edgecollective/soil-health/arduino/README.md

# dev notes

chirp-feather-m0_encoder_acclimat_voltage_sleep works with the latest chirp stack (and the prior -- so all code is compatible)

the current soil breakout board connects the io pin to pin 12, so that is how the code is set up

chirpstack is admin, admin
[ipaddres]:8080
pi
rakcat999
