edgecollective/soil-health/updates/update_002.md

# Update 2

## Done Previously:

- Remote node connected to acclima, acquiring data
- Gateway posting data to FarmOS
- Gateway posting data to Google Sheets
- Gateway remote login ability at Patrick's (not Dave's)

## Todo:

- Boost radio range
- Assess power consumption on remote node
- Optimize power circuit on remote node (e.g. solar)
- Set gateway up for multiple nodes posting to FarmOS 
- Design remote node that can be mass-produced easily

## Update on todos:
