edgecollective/soil-health/updates/update_003.md

# notes w setup w patrick 03 15 20

## wifi setup

### via file

wpa_supplicant.conf file format if needed, ref: https://www.raspberrypi.org/forums/viewtopic.php?t=203716

### via desktop

## ip endpoint
