edgecollective/soil-health/docs/rak_terminal.png

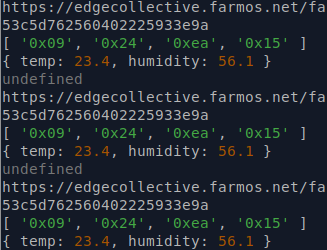
docs/rak_terminal.png
