edgecollective/soil-health/docs/rak_update.png

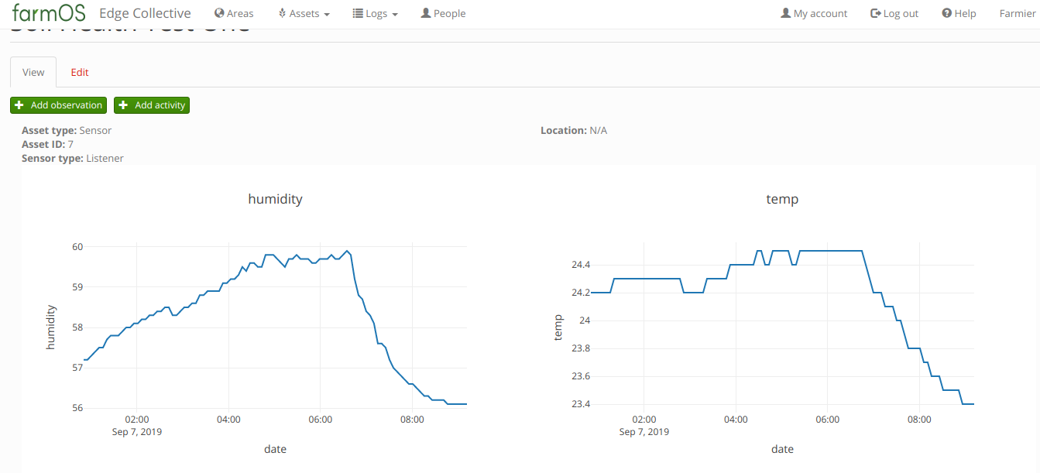
docs/rak_update.png
