edgecollective/soil-health/hardware/remote-v2/sh1/feather_schem.png

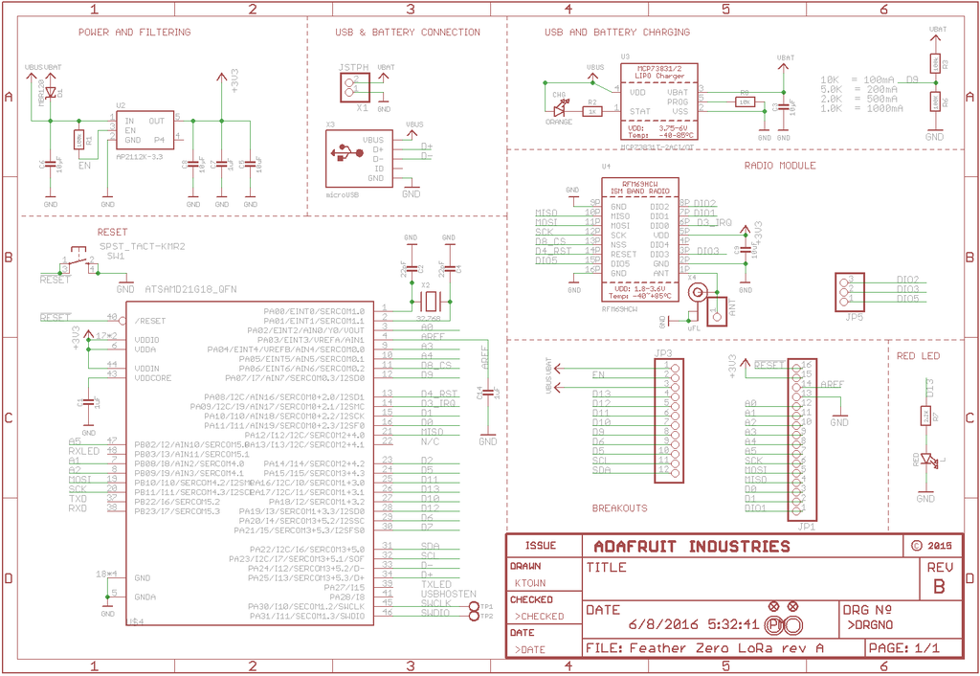
hardware/remote-v2/sh1/feather_schem.png
