edgecollective/soil-health/hardware/remote-v2/sh1/knuth_2.png

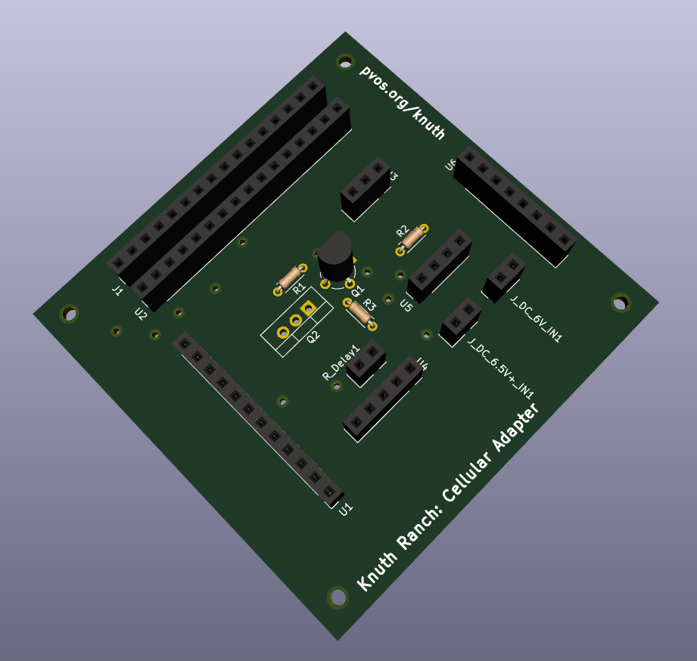
hardware/remote-v2/sh1/knuth_2.png
