edgecollective/soil-health/hardware/remote-v2/sh1/pics/flatcam.png

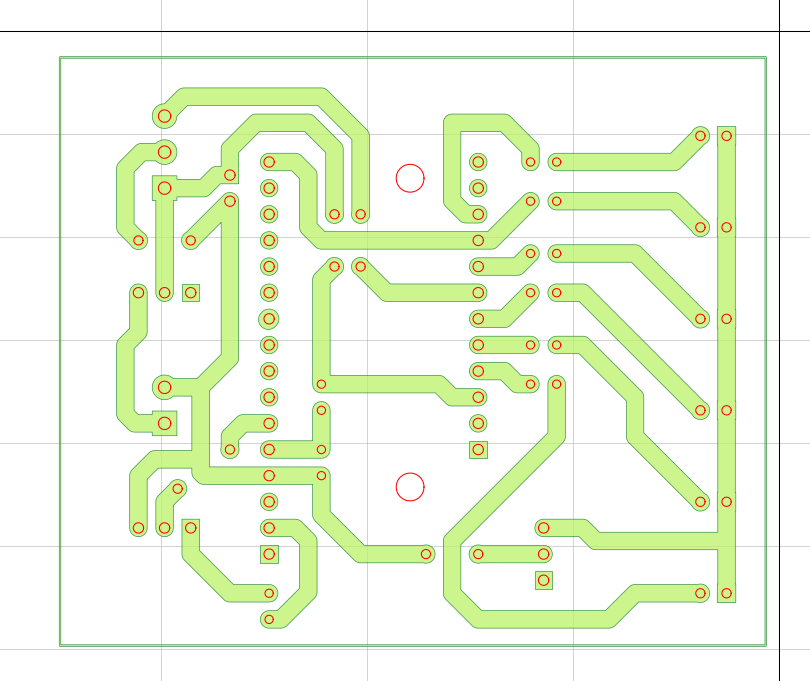
hardware/remote-v2/sh1/pics/flatcam.png
