edgecollective/soil-health/hardware/remote-v2/sh1/pics/layout.png

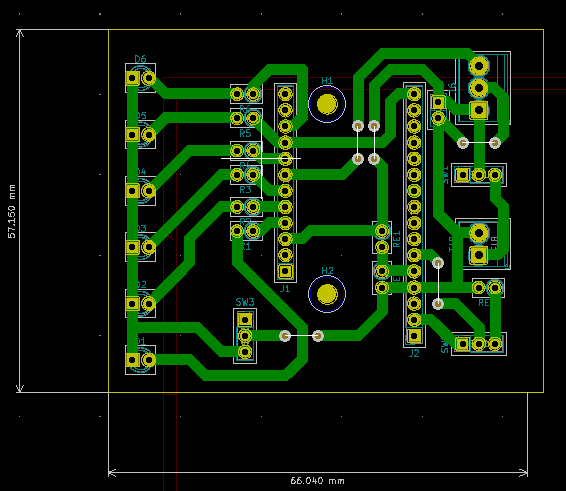
hardware/remote-v2/sh1/pics/layout.png
