edgecollective/soil-health/hardware/remote-v2/sh1/pics/layout_3d.png

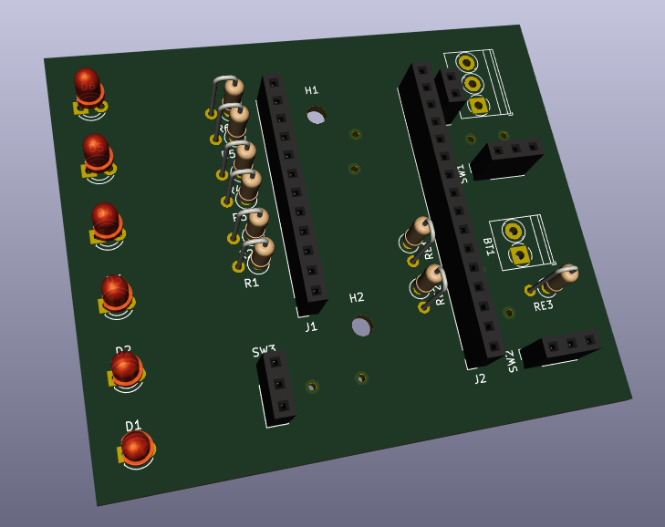
hardware/remote-v2/sh1/pics/layout_3d.png
