edgecollective/soil-health/hardware/remote-v2/sh1/relay_v2.png

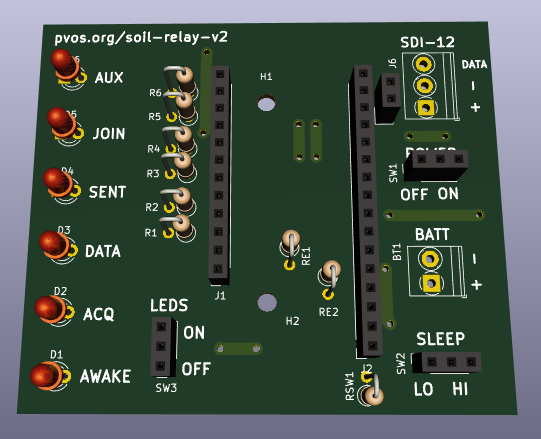
hardware/remote-v2/sh1/relay_v2.png
