edgecollective/soil-health/hardware/remote-v2/sh1/relay_v2_white.png

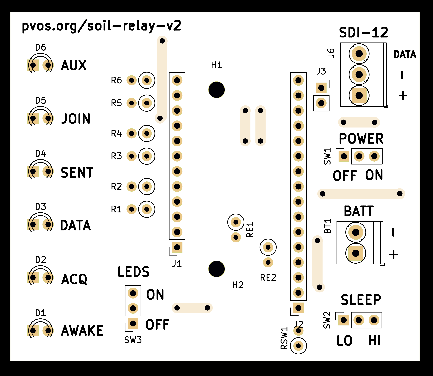
hardware/remote-v2/sh1/relay_v2_white.png
