edgecollective/soil-health/hardware/remote-v2/sh1/remote_3d_view.png

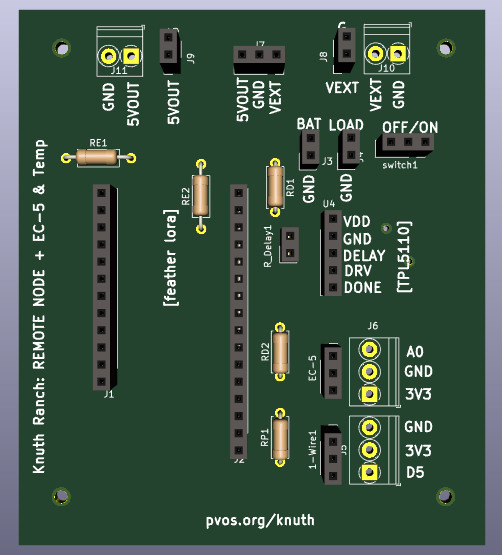
hardware/remote-v2/sh1/remote_3d_view.png
