edgecollective/soil-health/hardware/remote-v2/sh1/snapshot.png

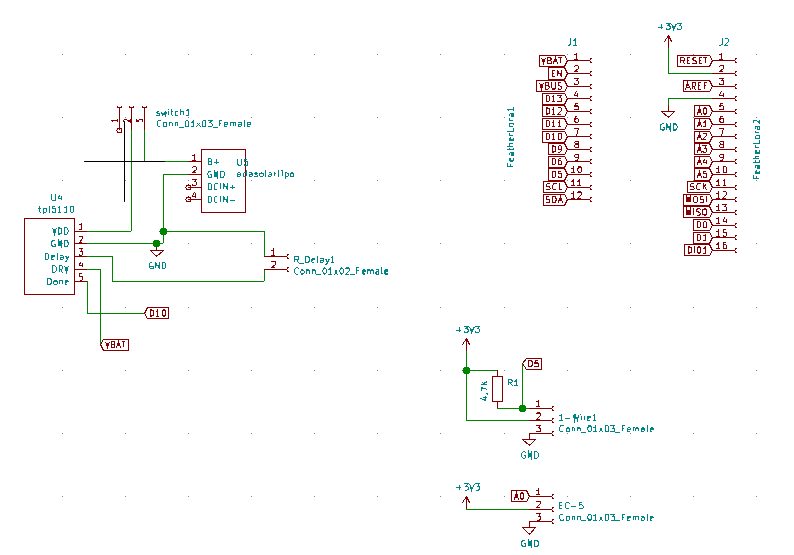
hardware/remote-v2/sh1/snapshot.png
