edgecollective/soil-health/range_exps/prospect2.png

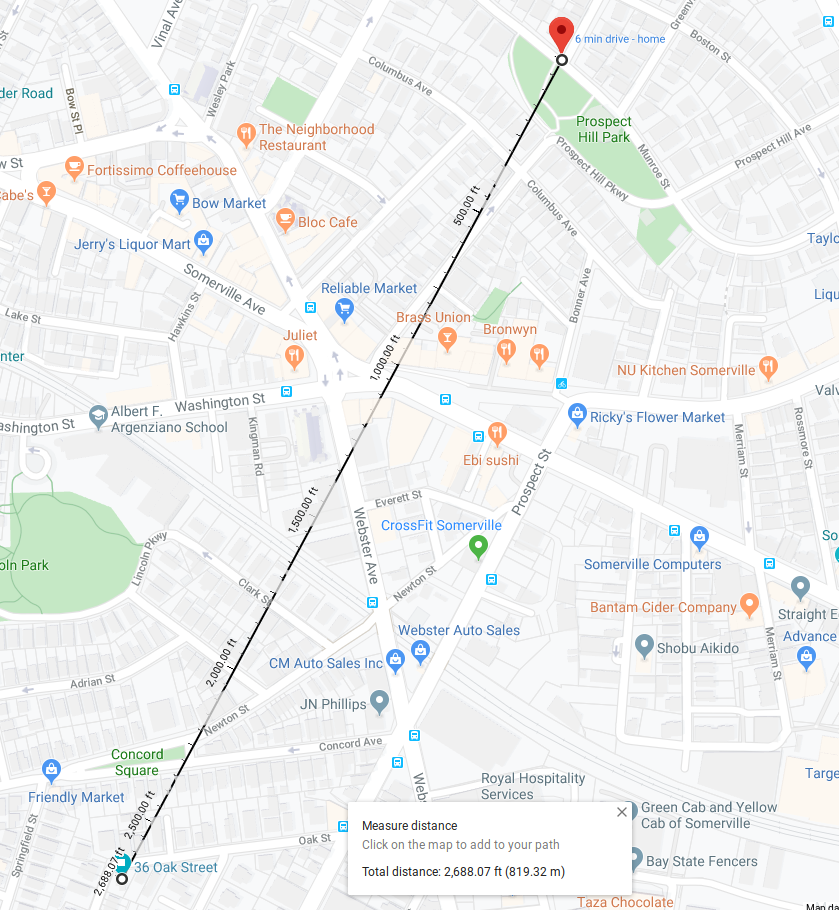
range_exps/prospect2.png
