edgecollective/soil-health/range_exps/prospect.png

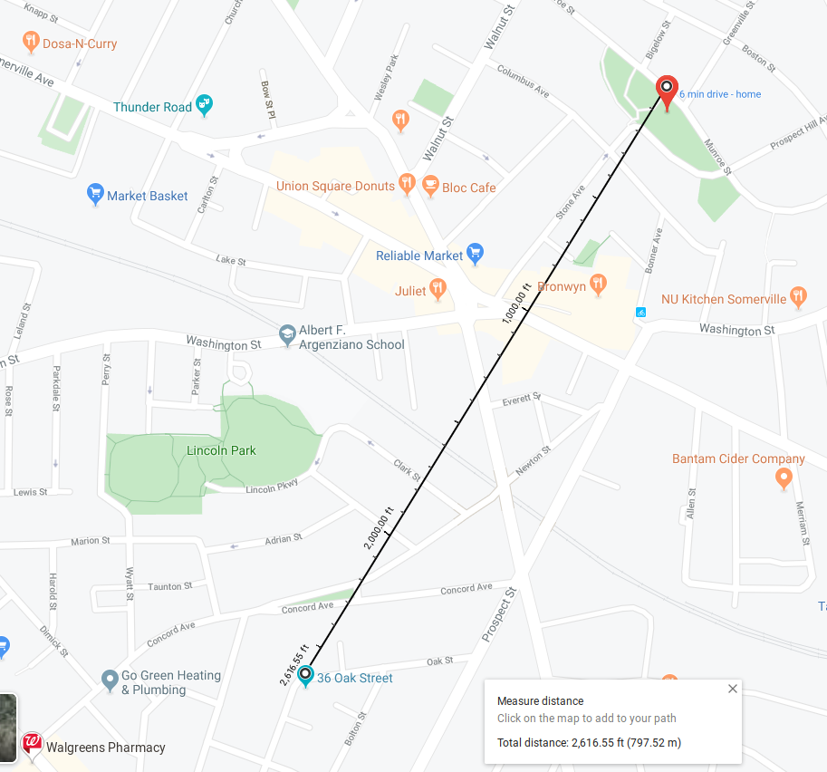
range_exps/prospect.png
