edgecollective/soil-health/range_exps/tides.png

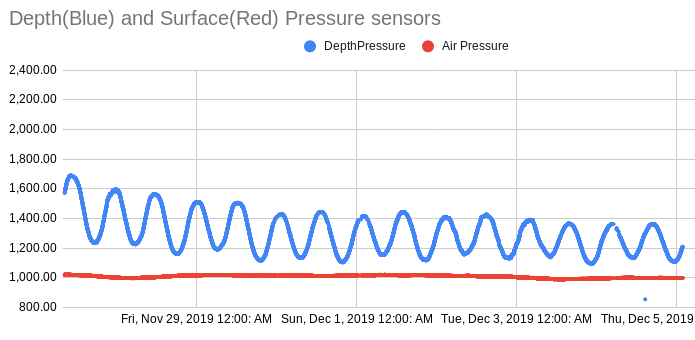
range_exps/tides.png
