edgecollective/soil-health/updates/assets/enclosure.jpeg

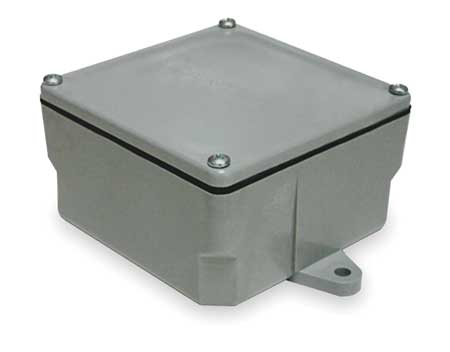
updates/assets/enclosure.jpeg
