edgecollective/soil-health/updates/assets/florida.png

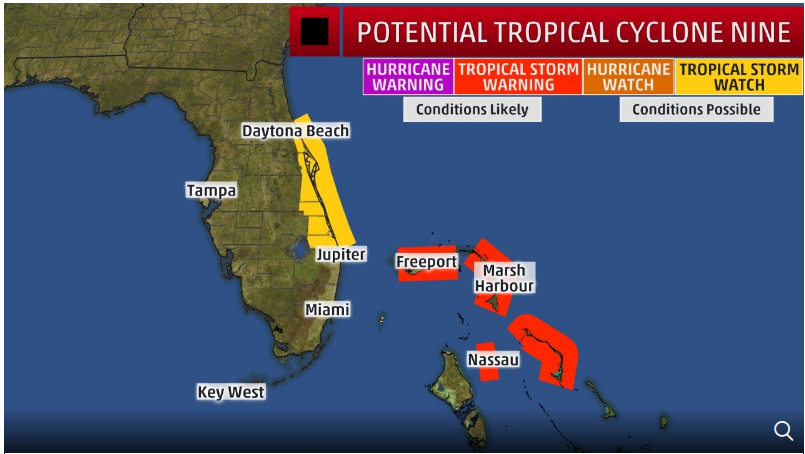
updates/assets/florida.png
