edgecollective/soil-health/updates/assets/gps.JPG

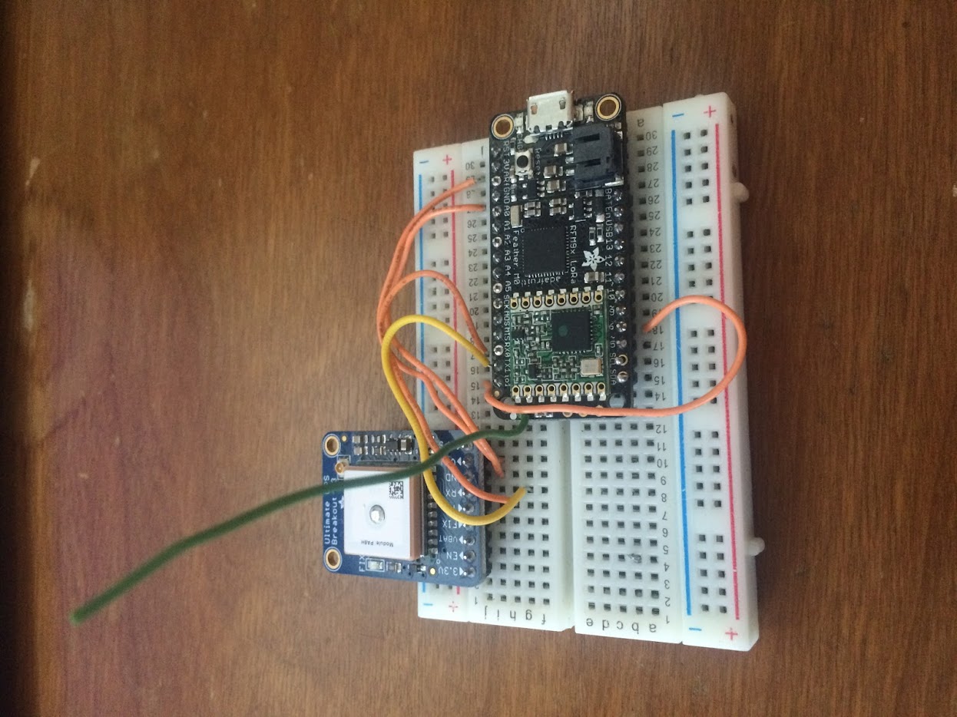
updates/assets/gps.JPG
