edgecollective/soil-health/updates/assets/littleton.png

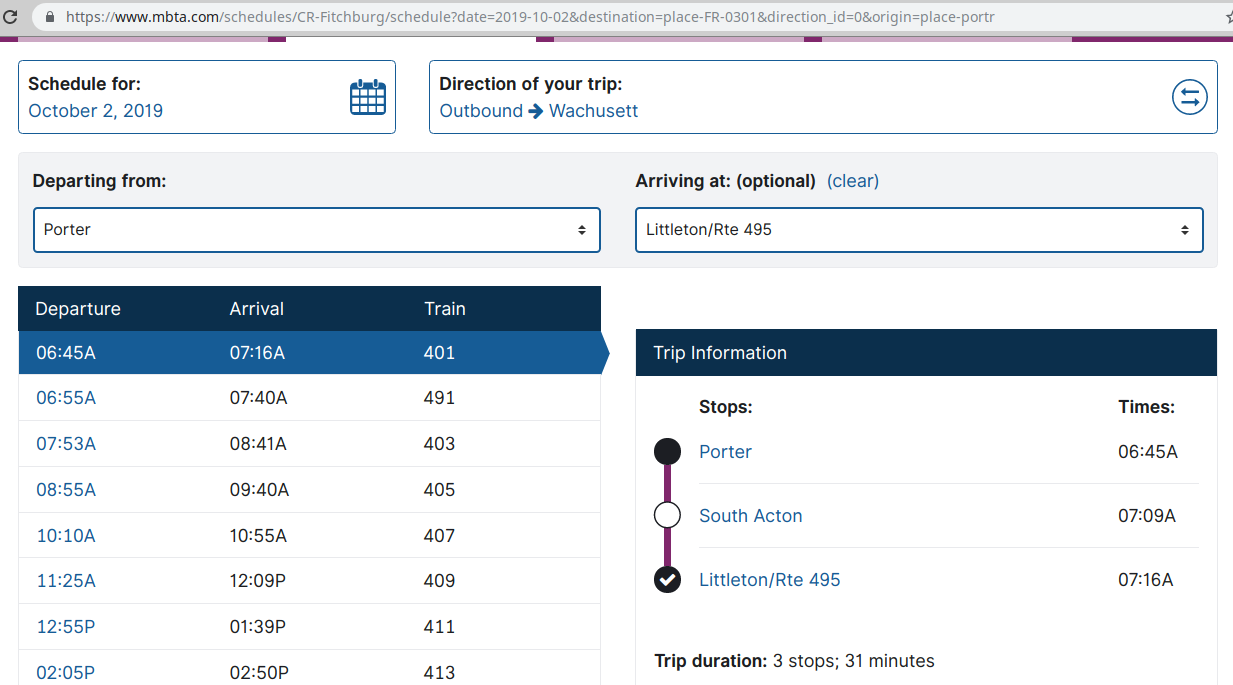
updates/assets/littleton.png
