edgecollective/soil-health/updates/assets/lora_close.JPG

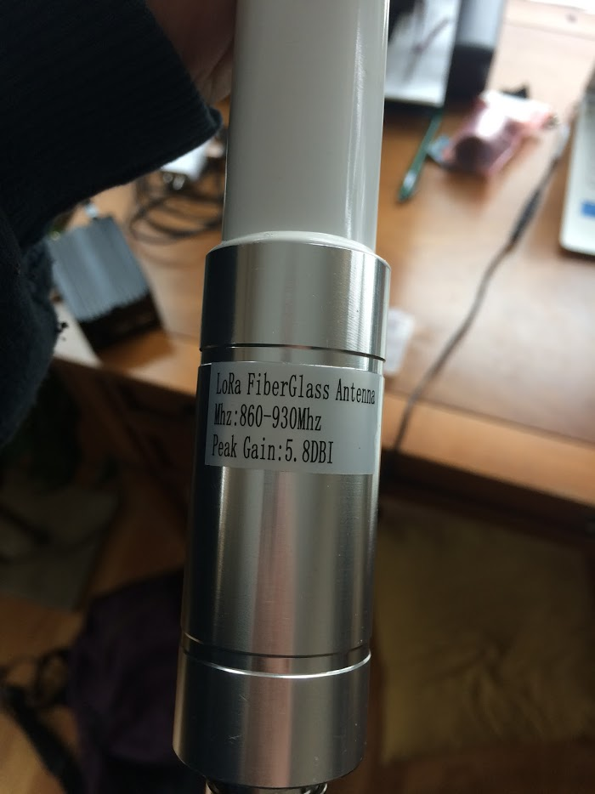
updates/assets/lora_close.JPG
