edgecollective/soil-health/updates/assets/lora_held.JPG

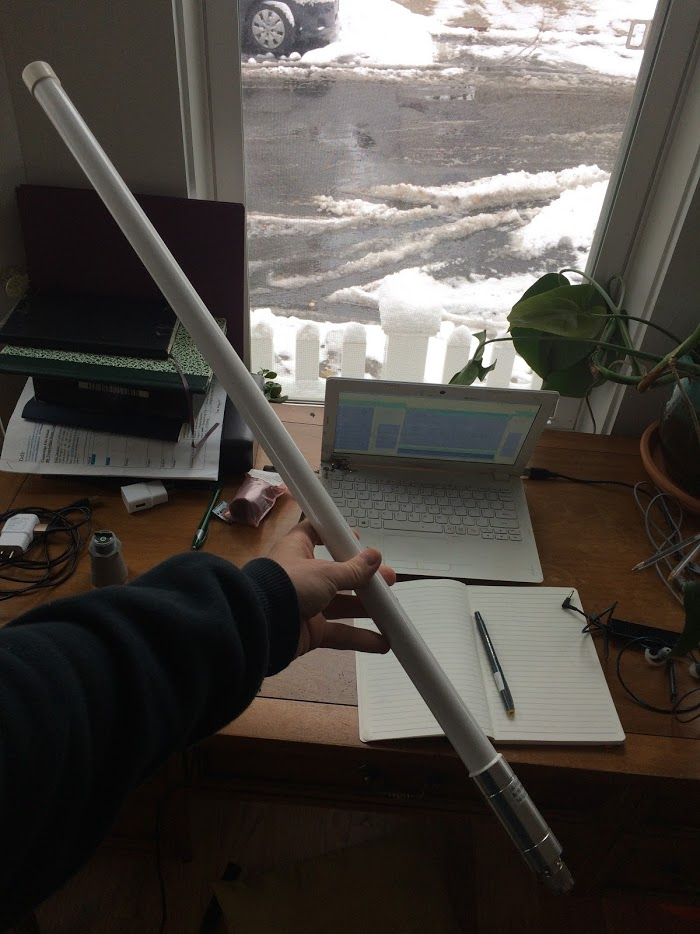
updates/assets/lora_held.JPG
