edgecollective/soil-health/updates/assets/patrick_temp.png

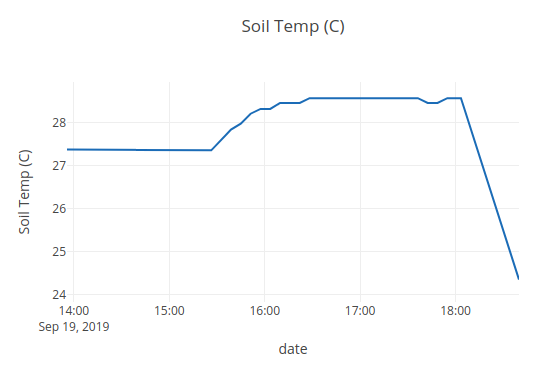
updates/assets/patrick_temp.png
