edgecollective/soil-health/updates/assets/vol_water_content_patrick.png

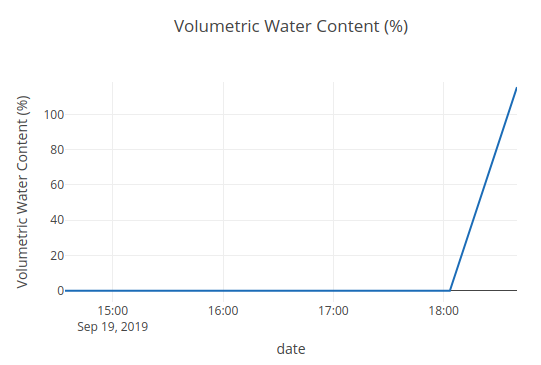
updates/assets/vol_water_content_patrick.png
