edgecollective/soil-health/updates/assets/volumetric_water_19_20am.png

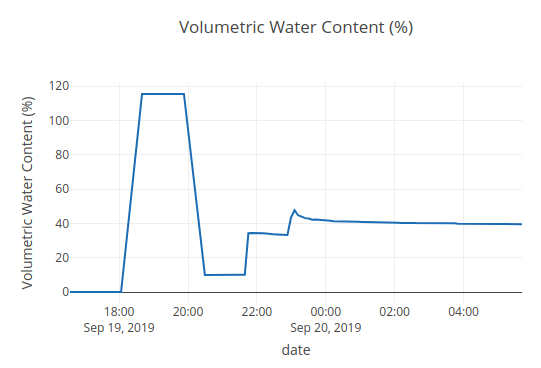
updates/assets/volumetric_water_19_20am.png
