edgecollective/soil-health/updates/assets/waterPulse.png

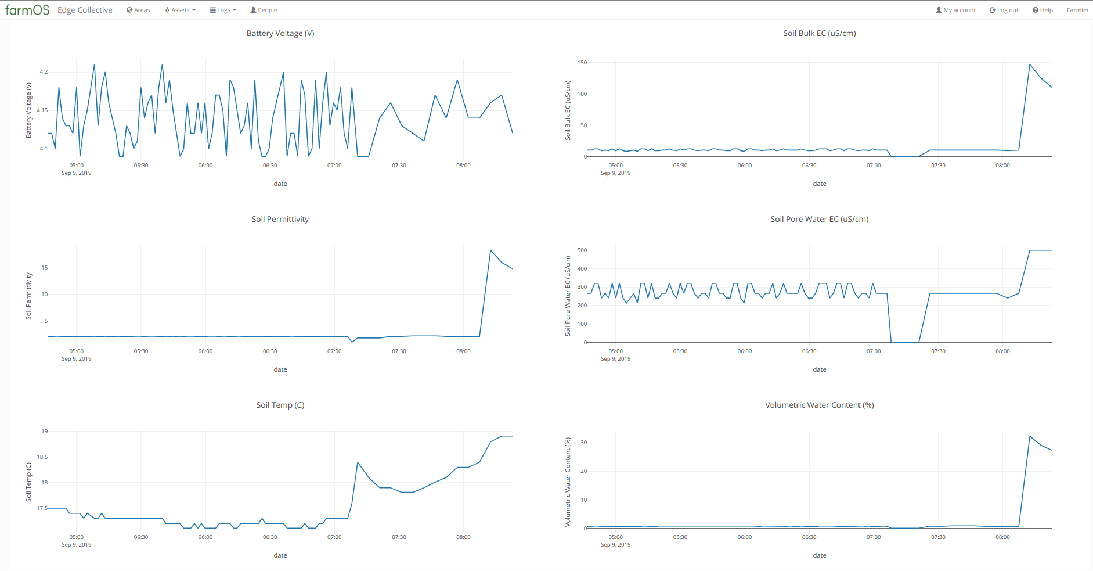
updates/assets/waterPulse.png
