edgecollective/soil-health/guides/prototype_001/assets/6_min_resistor.png

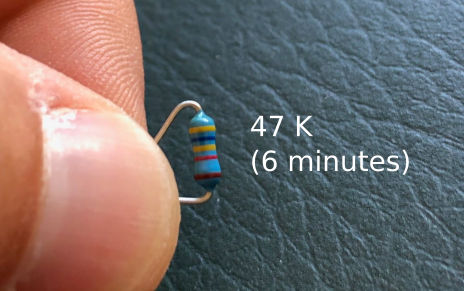
guides/prototype_001/assets/6_min_resistor.png
