edgecollective/soil-health/guides/prototype_001/assets/8_min_resistor.jpeg

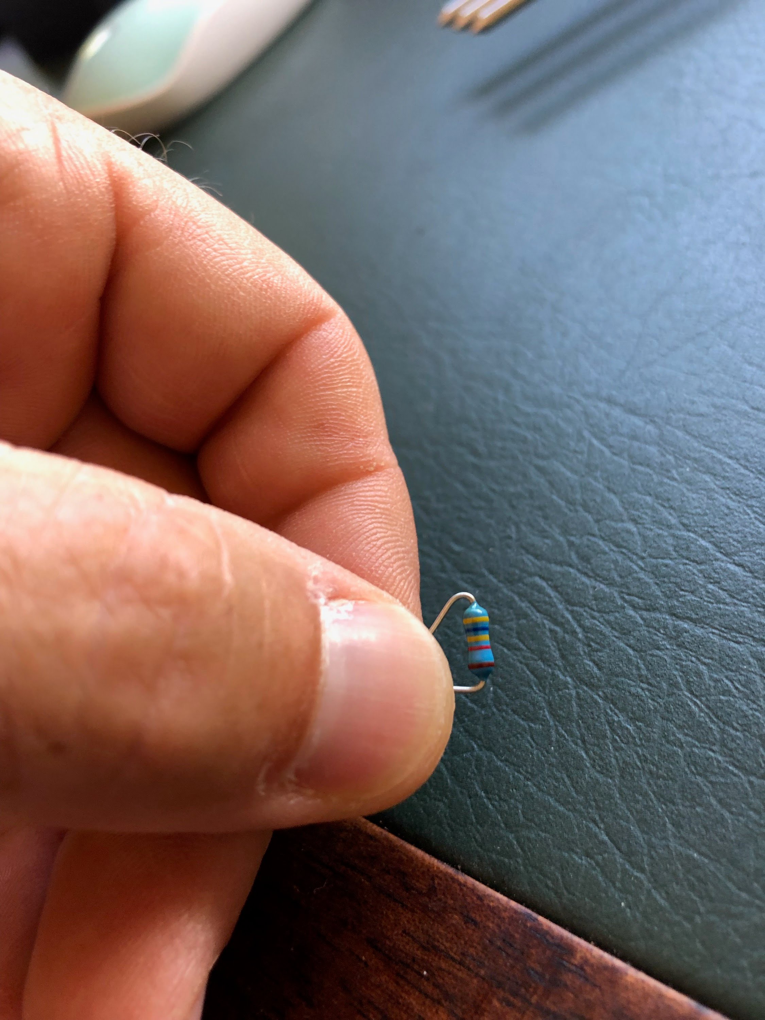
guides/prototype_001/assets/8_min_resistor.jpeg
