edgecollective/soil-health/guides/prototype_001/assets/acclima_wiring.png

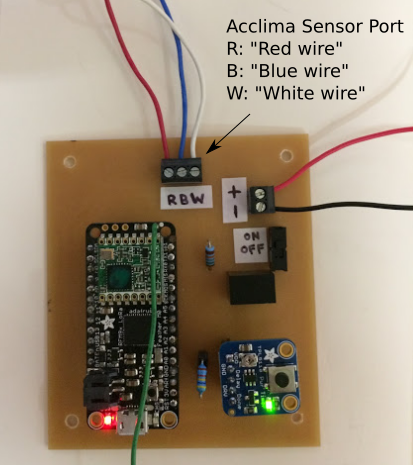
guides/prototype_001/assets/acclima_wiring.png
