edgecollective/soil-health/guides/prototype_001/assets/battery_wiring.png

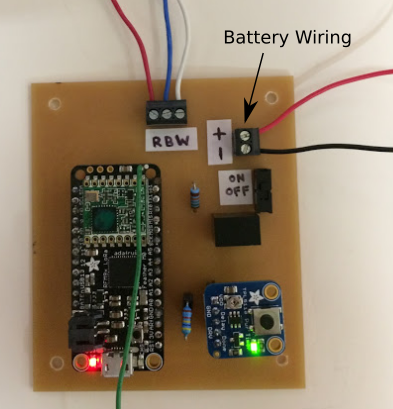
guides/prototype_001/assets/battery_wiring.png
