edgecollective/soil-health/guides/prototype_001/assets/enclosure.png

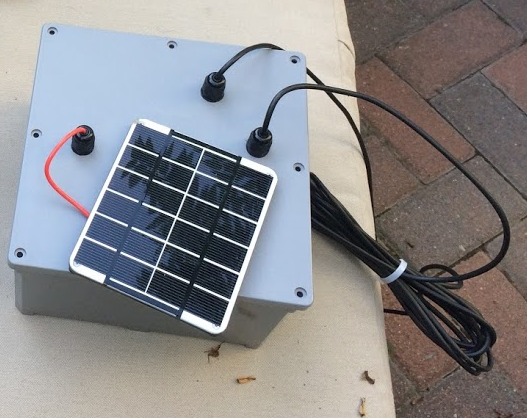
guides/prototype_001/assets/enclosure.png
