edgecollective/soil-health/guides/prototype_001/assets/farmos.png

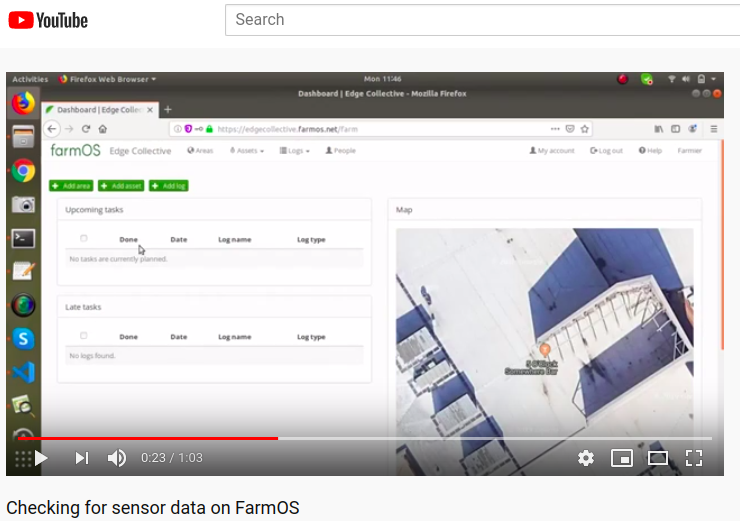
guides/prototype_001/assets/farmos.png
