edgecollective/soil-health/guides/prototype_001/assets/gateway_applications.png

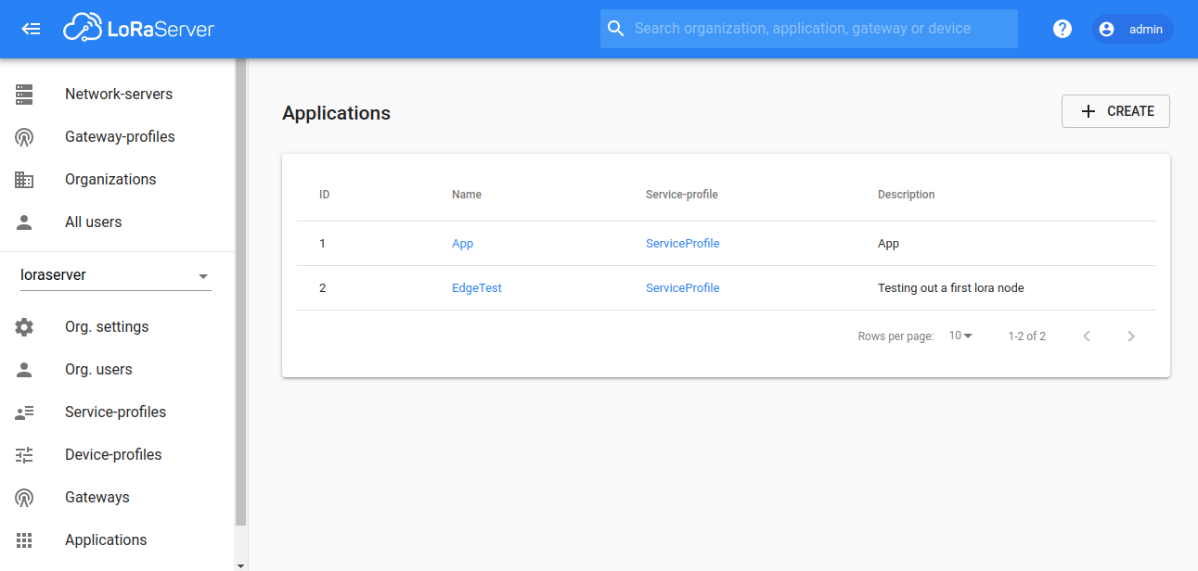
guides/prototype_001/assets/gateway_applications.png
