edgecollective/soil-health/guides/prototype_001/assets/gateway_applications_app.png

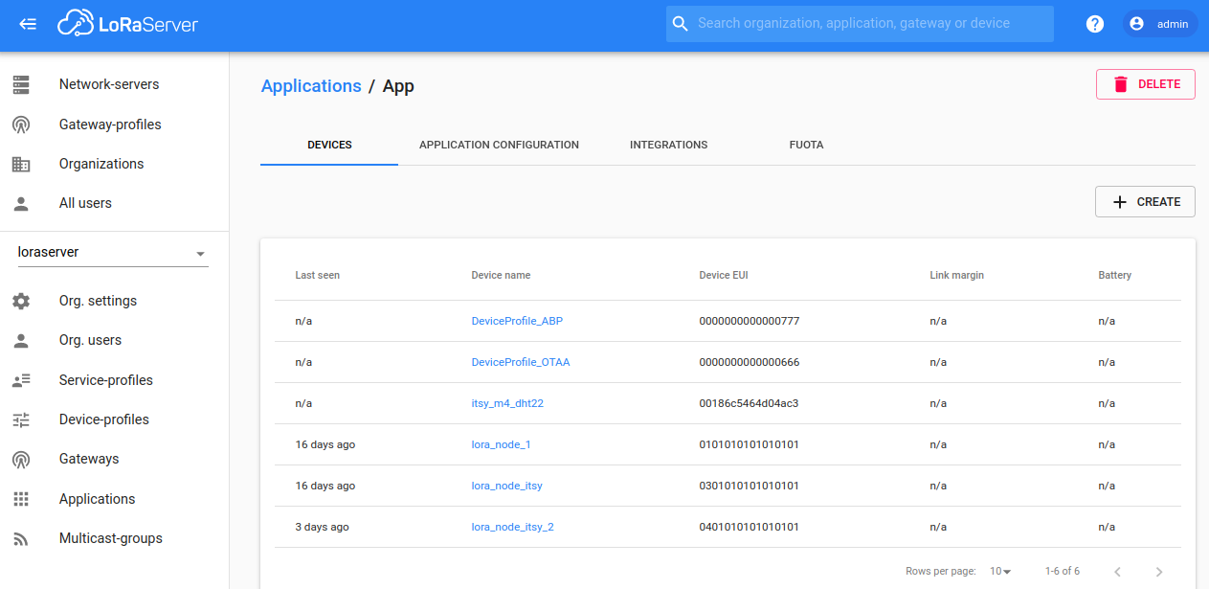
guides/prototype_001/assets/gateway_applications_app.png
