edgecollective/soil-health/guides/prototype_001/assets/gateway_applications_app_devices_data.png

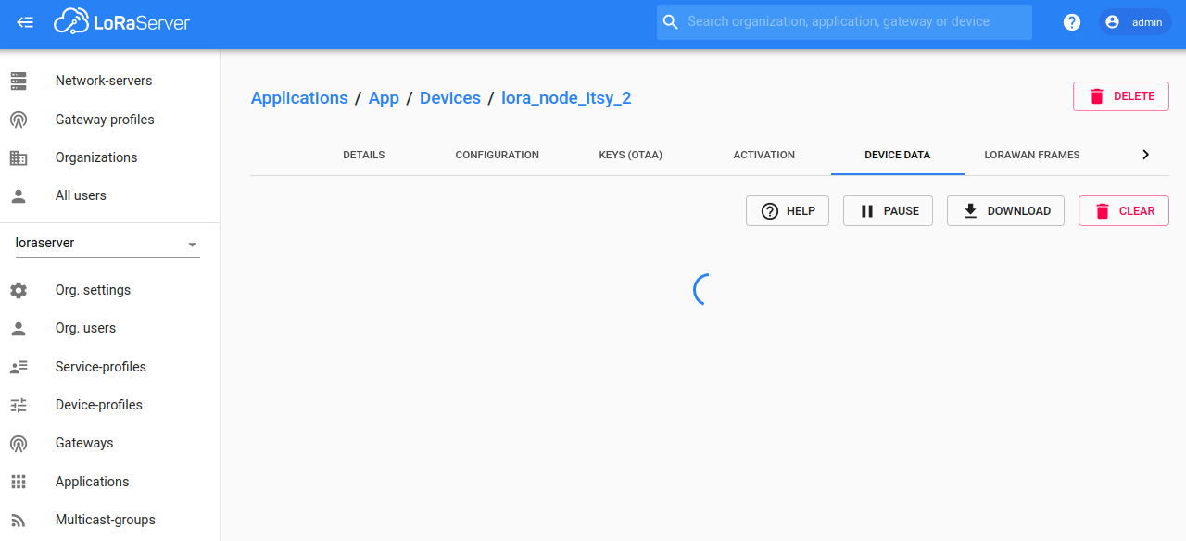
guides/prototype_001/assets/gateway_applications_app_devices_data.png
