edgecollective/soil-health/guides/prototype_001/assets/gateway_login.png

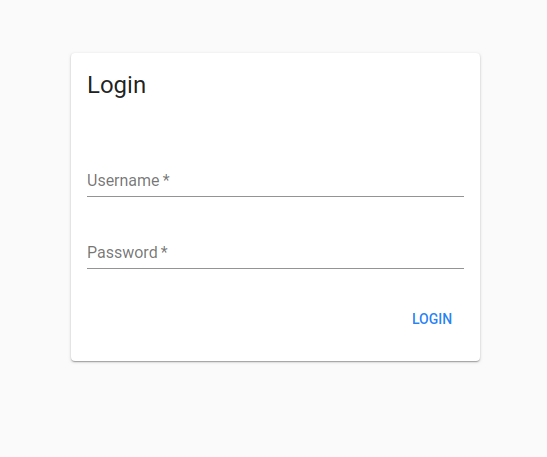
guides/prototype_001/assets/gateway_login.png
