edgecollective/soil-health/guides/prototype_001/assets/gateway_video.png

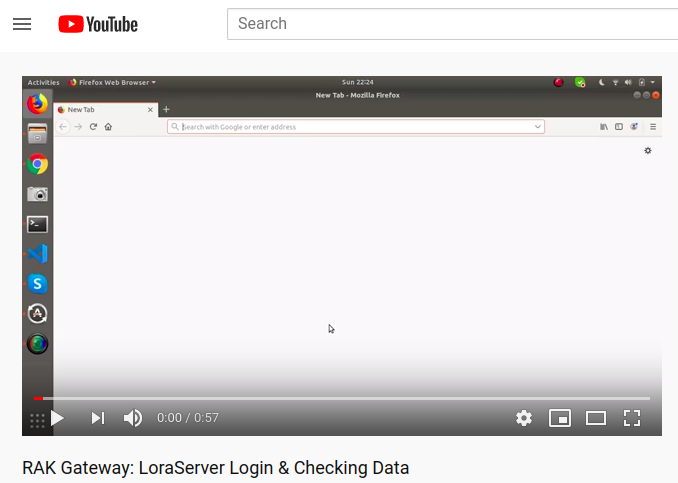
guides/prototype_001/assets/gateway_video.png
