edgecollective/soil-health/guides/prototype_001/assets/gateway_waiting.png

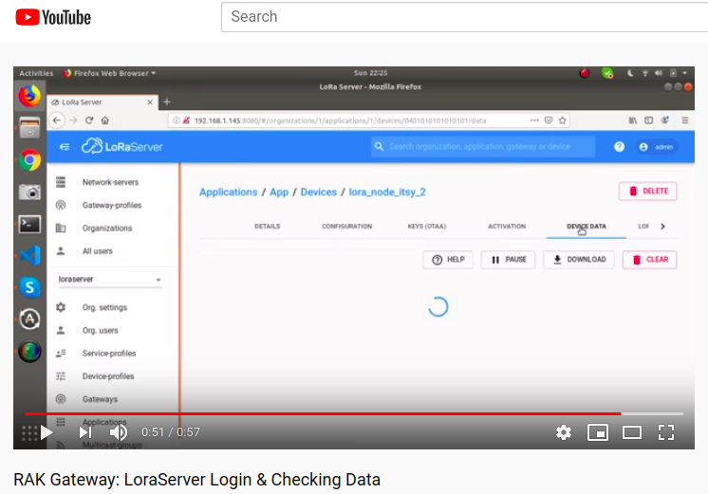
guides/prototype_001/assets/gateway_waiting.png
