edgecollective/soil-health/guides/prototype_001/assets/glands.png

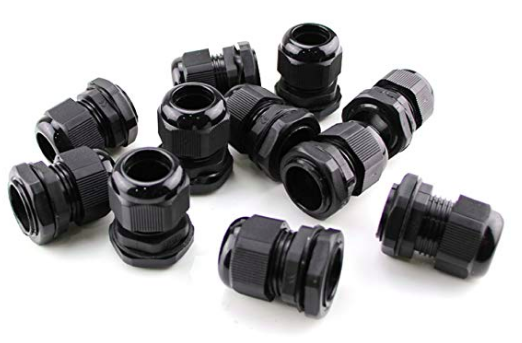
guides/prototype_001/assets/glands.png
