edgecollective/soil-health/guides/prototype_001/assets/junction.jpg

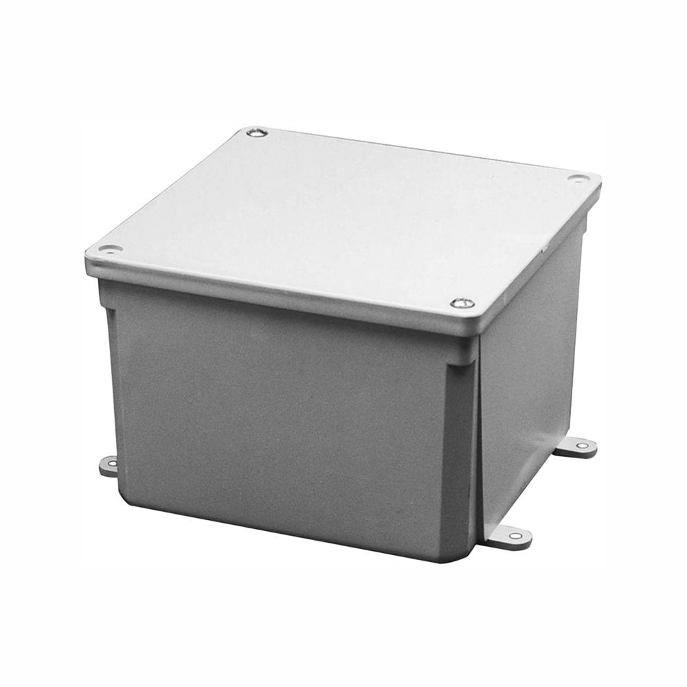
guides/prototype_001/assets/junction.jpg
