edgecollective/soil-health/guides/prototype_001/assets/remote_on.JPG

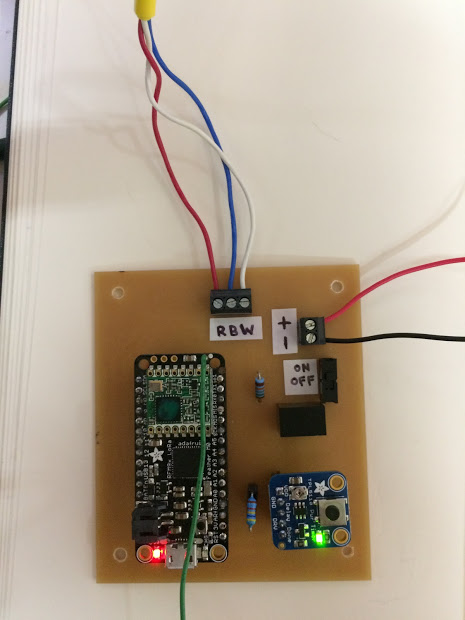
guides/prototype_001/assets/remote_on.JPG
