edgecollective/soil-health/guides/prototype_001/assets/timer_resistor.JPG

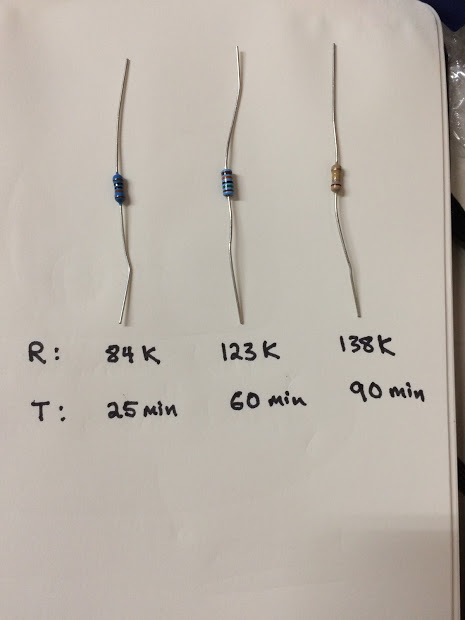
guides/prototype_001/assets/timer_resistor.JPG
