edgecollective/soil-health/guides/prototype_001/assets/timing_resistor.png

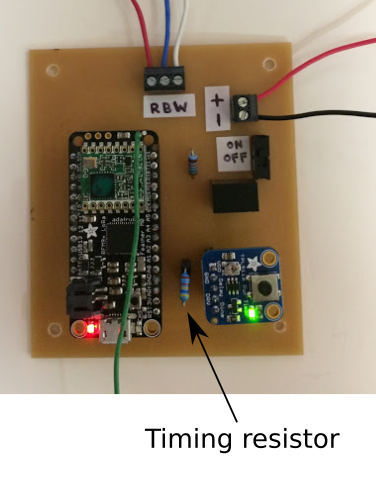
guides/prototype_001/assets/timing_resistor.png
