edgecollective/soil-health/guides/prototype_001/assets/wiring.JPG

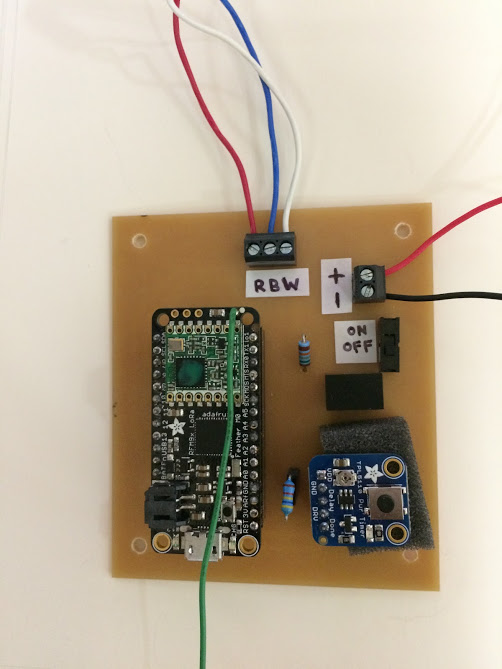
guides/prototype_001/assets/wiring.JPG
