edgecollective/soil-health/docs/acclima_test.png

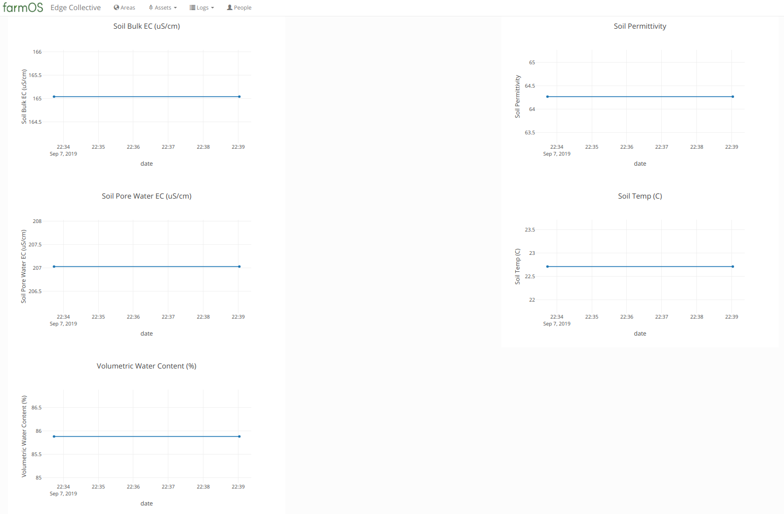
docs/acclima_test.png
