edgecollective/soil-health/arduino/chirp-feather-m0_encoder_acclima_voltage_sleep/chirp-feather-m0_encoder_acclima_voltage_sleep.ino

/*******************************************************************************
 * Copyright (c) 2015 Thomas Telkamp and Matthijs Kooijman
 * Copyright (c) 2018 Terry Moore, MCCI
 *
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
 * This example sends a valid LoRaWAN packet with payload "Hello,
 * world!", using frequency and encryption settings matching those of
 * the The Things Network. It's pre-configured for the Adafruit
 * Feather M0 LoRa.
 *
 * This uses OTAA (Over-the-air activation), where where a DevEUI and
 * application key is configured, which are used in an over-the-air
 * activation procedure where a DevAddr and session keys are
 * assigned/generated for use with all further communication.
 *
 * Note: LoRaWAN per sub-band duty-cycle limitation is enforced (1% in
 * g1, 0.1% in g2), but not the TTN fair usage policy (which is probably
 * violated by this sketch when left running for longer)!

 * To use this sketch, first register your application and device with
 * the things network, to set or generate an AppEUI, DevEUI and AppKey.
 * Multiple devices can use the same AppEUI, but each device has its own
 * DevEUI and AppKey.
 *
 * Do not forget to define the radio type correctly in
 * arduino-lmic/project_config/lmic_project_config.h or from your BOARDS.txt.
 *
 *******************************************************************************/
#define VBATPIN A7
#include <lmic.h>
#include <hal/hal.h>
#include <SPI.h>
//#include <LoraEncoder.h>
//#include <LoraMessage.h>

#define decoder_divider 5000

#include <SDI12.h>

#define DONE_PIN 10 // the done pin for the timer

#define SERIAL_BAUD 115200  // The baud rate for the output serial port
#define DATA_PIN 6         // The pin of the SDI-12 data bus
#define POWER_PIN -1       // The sensor power pin (or -1 if not switching power)

// Define the SDI-12 bus
SDI12 mySDI12(DATA_PIN);

// variable that alternates output type back and forth between parsed and raw
boolean flip = 1;

// https://acclima.com/prodlit/TDR%20User%20Manual.pdf


const unsigned TX_INTERVAL = 90;


#define num_params 6 // 5 from soil moisture, 6th is battery voltage

float params[num_params]; // acclima params

byte addressRegister[8] = {
  0B00000000,
  0B00000000,
  0B00000000,
  0B00000000,
  0B00000000,
  0B00000000,
  0B00000000,
  0B00000000
};

uint8_t numSensors = 0;

// converts allowable address characters '0'-'9', 'a'-'z', 'A'-'Z',
// to a decimal number between 0 and 61 (inclusive) to cover the 62 possible addresses
byte charToDec(char i){
  if((i >= '0') && (i <= '9')) return i - '0';
  if((i >= 'a') && (i <= 'z')) return i - 'a' + 10;
  if((i >= 'A') && (i <= 'Z')) return i - 'A' + 37;
  else return i;
}

// THIS METHOD IS UNUSED IN THIS EXAMPLE, BUT IT MAY BE HELPFUL.
// maps a decimal number between 0 and 61 (inclusive) to
// allowable address characters '0'-'9', 'a'-'z', 'A'-'Z',
char decToChar(byte i){
  if(i <= 9) return i + '0';
  if((i >= 10) && (i <= 36)) return i + 'a' - 10;
  if((i >= 37) && (i <= 62)) return i + 'A' - 37;
  else return i;
}

// gets identification information from a sensor, and prints it to the serial port
// expects a character between '0'-'9', 'a'-'z', or 'A'-'Z'.
void printInfo(char i){
  String command = "";
  command += (char) i;
  command += "I!";
  mySDI12.sendCommand(command);
  delay(30);

  while(mySDI12.available()){
    char c = mySDI12.read();
    if((c!='\n') && (c!='\r')) Serial.write(c);
    delay(5);
  }
}

void printBufferToScreen(){

    mySDI12.read();  // discard address
    int param = 0;
    while(mySDI12.available()){
        float that = mySDI12.parseFloat();
        if(that != mySDI12.TIMEOUT){    //check for timeout
          //float doubleThat = that * 2;
          params[param]=that;
          
          Serial.print("\n");
          Serial.print("param ");
          Serial.print(param);
          Serial.print(" = ");
          Serial.println(that);
          param++;
          //Serial.print(" x 2 = ");
          //Serial.print(doubleThat);
        }
      
    }
    Serial.println();

}


void getParams(){

    mySDI12.read();  // discard address
    int param = 0;
    while(mySDI12.available()){
        float that = mySDI12.parseFloat();
        if(that != mySDI12.TIMEOUT){    //check for timeout
          //float doubleThat = that * 2;
          params[param]=that;
          
          param++;

        } 
    }

    // read the battery voltage
    float measuredvbat = analogRead(VBATPIN);
measuredvbat *= 2;    // we divided by 2, so multiply back
measuredvbat *= 3.3;  // Multiply by 3.3V, our reference voltage
measuredvbat /= 1024; // convert to voltage
Serial.print("VBat: " ); Serial.println(measuredvbat);
     params[param]=measuredvbat;
    
    Serial.println();

}

void takeMeasurement(char i){
  String command = "";
  command += i;
  command += "M!"; // SDI-12 measurement command format  [address]['M'][!]
  mySDI12.sendCommand(command);
  delay(30);

  // wait for acknowlegement with format [address][ttt (3 char, seconds)][number of measurments available, 0-9]
  String sdiResponse = "";
  delay(30);
  while (mySDI12.available())  // build response string
  {
    char c = mySDI12.read();
    if ((c != '\n') && (c != '\r'))
    {
      sdiResponse += c;
      delay(5);
    }
  }
  mySDI12.clearBuffer();

  // find out how long we have to wait (in seconds).
  uint8_t wait = 0;
  wait = sdiResponse.substring(1,4).toInt();

  // Set up the number of results to expect
  // int numMeasurements =  sdiResponse.substring(4,5).toInt();

  unsigned long timerStart = millis();
  while((millis() - timerStart) < (1000 * wait)){
    if(mySDI12.available())  // sensor can interrupt us to let us know it is done early
    {
      mySDI12.clearBuffer();
      break;
    }
  }
  // Wait for anything else and clear it out
  delay(30);
  mySDI12.clearBuffer();

  // in this example we will only take the 'DO' measurement
  command = "";
  command += i;
  command += "D0!"; // SDI-12 command to get data [address][D][dataOption][!]
  mySDI12.sendCommand(command);
  while(!(mySDI12.available()>1)){}  // wait for acknowlegement
  delay(300); // let the data transfer
  
  //printBufferToScreen();
  getParams();
  
  mySDI12.clearBuffer();
}

// this checks for activity at a particular address
// expects a char, '0'-'9', 'a'-'z', or 'A'-'Z'
boolean checkActive(char i){

  String myCommand = "";
  myCommand = "";
  myCommand += (char) i;                 // sends basic 'acknowledge' command [address][!]
  myCommand += "!";

  for(int j = 0; j < 3; j++){            // goes through three rapid contact attempts
    mySDI12.sendCommand(myCommand);
    delay(30);
    if(mySDI12.available()) {  // If we here anything, assume we have an active sensor
      printBufferToScreen();
      mySDI12.clearBuffer();
      return true;
    }
  }
  mySDI12.clearBuffer();
  return false;
}

// this quickly checks if the address has already been taken by an active sensor
boolean isTaken(byte i){
  i = charToDec(i); // e.g. convert '0' to 0, 'a' to 10, 'Z' to 61.
  byte j = i / 8;   // byte #
  byte k = i % 8;   // bit #
  return addressRegister[j] & (1<<k); // return bit status
}

// this sets the bit in the proper location within the addressRegister
// to record that the sensor is active and the address is taken.
boolean setTaken(byte i){
  boolean initStatus = isTaken(i);
  i = charToDec(i); // e.g. convert '0' to 0, 'a' to 10, 'Z' to 61.
  byte j = i / 8;   // byte #
  byte k = i % 8;   // bit #
  addressRegister[j] |= (1 << k);
  return !initStatus; // return false if already taken
}

// THIS METHOD IS UNUSED IN THIS EXAMPLE, BUT IT MAY BE HELPFUL.
// this unsets the bit in the proper location within the addressRegister
// to record that the sensor is active and the address is taken.
boolean setVacant(byte i){
  boolean initStatus = isTaken(i);
  i = charToDec(i); // e.g. convert '0' to 0, 'a' to 10, 'Z' to 61.
  byte j = i / 8;   // byte #
  byte k = i % 8;   // bit #
  addressRegister[j] &= ~(1 << k);
  return initStatus; // return false if already vacant
}



// Radio stuff

// This EUI must be in little-endian format, so least-significant-byte
// first. When copying an EUI from ttnctl output, this means to reverse
// the bytes. For TTN issued EUIs the last bytes should be 0xD5, 0xB3,
// 0x70.
static const u1_t PROGMEM APPEUI[8]= {0x22,0x22,0x22,0x22,0x22,0x22,0x22,0x22};
void os_getArtEui (u1_t* buf) { memcpy_P(buf, APPEUI, 8);}

// This should also be in little endian format, see above.
static const u1_t PROGMEM DEVEUI[8]= {0x35,0x95,0xb5,0xbd,0xde,0x86,0x7c,0x17};
void os_getDevEui (u1_t* buf) { memcpy_P(buf, DEVEUI, 8);}

// This key should be in big endian format (or, since it is not really a
// number but a block of memory, endianness does not really apply). In
// practice, a key taken from the TTN console can be copied as-is.
static const u1_t PROGMEM APPKEY[16] = { 0x58,0x0c,0x7a,0xc9,0x85,0x95,0x99,0xf2,0xca,0xcb,0x79,0x15,0x0a,0x45,0x6f,0x39 };
void os_getDevKey (u1_t* buf) {  memcpy_P(buf, APPKEY, 16);}

//static uint8_t mydata[3];
// seem to need to add one to the number of bytes that the encoder system expects

static osjob_t sendjob;

// Schedule TX every this many seconds (might become longer due to duty
// cycle limitations).
//const unsigned TX_INTERVAL = 10;

// need to connect pin 12 to i01 on Feather M0
// Pin mapping for Adafruit Feather M0 LoRa, etc.
const lmic_pinmap lmic_pins = {
    .nss = 8,
    .rxtx = LMIC_UNUSED_PIN,
    .rst = 4,
    .dio = {3, 12, LMIC_UNUSED_PIN},
    .rxtx_rx_active = 0,
    .rssi_cal = 8,              // LBT cal for the Adafruit Feather M0 LoRa, in dB
    .spi_freq = 8000000,
};

void onEvent (ev_t ev) {
    Serial.print(os_getTime());
    Serial.print(": ");
    switch(ev) {
        case EV_SCAN_TIMEOUT:
            Serial.println(F("EV_SCAN_TIMEOUT"));
            break;
        case EV_BEACON_FOUND:
            Serial.println(F("EV_BEACON_FOUND"));
            break;
        case EV_BEACON_MISSED:
            Serial.println(F("EV_BEACON_MISSED"));
            break;
        case EV_BEACON_TRACKED:
            Serial.println(F("EV_BEACON_TRACKED"));
            break;
        case EV_JOINING:
            Serial.println(F("EV_JOINING"));
            break;
        case EV_JOINED:
            Serial.println(F("EV_JOINED"));
            {
              u4_t netid = 0;
              devaddr_t devaddr = 0;
              u1_t nwkKey[16];
              u1_t artKey[16];
              LMIC_getSessionKeys(&netid, &devaddr, nwkKey, artKey);
              Serial.print("netid: ");
              Serial.println(netid, DEC);
              Serial.print("devaddr: ");
              Serial.println(devaddr, HEX);
              Serial.print("artKey: ");
              for (int i=0; i<sizeof(artKey); ++i) {
                if (i != 0)
                  Serial.print("-");
                Serial.print(artKey[i], HEX);
              }
              Serial.println("");
              Serial.print("nwkKey: ");
              for (int i=0; i<sizeof(nwkKey); ++i) {
                      if (i != 0)
                              Serial.print("-");
                      Serial.print(nwkKey[i], HEX);
              }
              Serial.println("");
            }
            // Disable link check validation (automatically enabled
            // during join, but because slow data rates change max TX
	    // size, we don't use it in this example.
            LMIC_setLinkCheckMode(0);
            break;
        /*
        || This event is defined but not used in the code. No
        || point in wasting codespace on it.
        ||
        || case EV_RFU1:
        ||     Serial.println(F("EV_RFU1"));
        ||     break;
        */
        case EV_JOIN_FAILED:
            Serial.println(F("EV_JOIN_FAILED"));
            break;
        case EV_REJOIN_FAILED:
            Serial.println(F("EV_REJOIN_FAILED"));
            break;
            break;
        case EV_TXCOMPLETE:
            Serial.println(F("EV_TXCOMPLETE (includes waiting for RX windows)"));
            if (LMIC.txrxFlags & TXRX_ACK)
              Serial.println(F("Received ack"));
              digitalWrite(DONE_PIN, HIGH);
              delay(1);
              digitalWrite(DONE_PIN, LOW);
              delay(1);
              
            if (LMIC.dataLen) {
              Serial.println(F("Received "));
              Serial.println(LMIC.dataLen);
              Serial.println(F(" bytes of payload"));
            }
            // Schedule next transmission
            os_setTimedCallback(&sendjob, os_getTime()+sec2osticks(TX_INTERVAL), do_send);
            break;
        case EV_LOST_TSYNC:
            Serial.println(F("EV_LOST_TSYNC"));
            break;
        case EV_RESET:
            Serial.println(F("EV_RESET"));
            break;
        case EV_RXCOMPLETE:
            // data received in ping slot
            Serial.println(F("EV_RXCOMPLETE"));
            break;
        case EV_LINK_DEAD:
            Serial.println(F("EV_LINK_DEAD"));
            break;
        case EV_LINK_ALIVE:
            Serial.println(F("EV_LINK_ALIVE"));
            break;
        /*
        || This event is defined but not used in the code. No
        || point in wasting codespace on it.
        ||
        || case EV_SCAN_FOUND:
        ||    Serial.println(F("EV_SCAN_FOUND"));
        ||    break;
        */
        case EV_TXSTART:
            Serial.println(F("EV_TXSTART"));
            break;
        default:
            Serial.print(F("Unknown event: "));
            Serial.println((unsigned) ev);
            break;
    }
}

void do_send(osjob_t* j){
    // Check if there is not a current TX/RX job running
    if (LMIC.opmode & OP_TXRXPEND) {
        Serial.println(F("OP_TXRXPEND, not sending"));
    } else {

// SDI-12 stuff

char i = '0';

for (int k=0;k<2;k++) {
    digitalWrite(LED_BUILTIN, HIGH);   // turn the LED on (HIGH is the voltage level)
  delay(1000);                       // wait for a second
  digitalWrite(LED_BUILTIN, LOW);    // turn the LED off by making the voltage LOW
  delay(1000);                       // wait for a second
}

     printInfo(i);
     takeMeasurement(i);
for (int k=0;k<3;k++) {
    digitalWrite(LED_BUILTIN, HIGH);   // turn the LED on (HIGH is the voltage level)
  delay(100);                       // wait for a second
  digitalWrite(LED_BUILTIN, LOW);    // turn the LED off by making the voltage LOW
  delay(100);                       // wait for a second
}
    
    for (int p=0;p<num_params;p++) {
      Serial.print("param ");
      Serial.print(p);
      Serial.print(" = ");
      Serial.println(params[p]);
    }
    Serial.println();

    //float temp = dht.readTemperature();
        //float humidity = dht.readHumidity();
        float temp = 24.5;
        float humidity = 33.;

        static uint8_t payload[2*num_params];
        
        for (int pi=0;pi<num_params;pi++) {
        //Serial.print("pi=");
        //Serial.println(pi);
        //Serial.println(params[pi]);
        int pj=pi*2;
        //Serial.println(pj);
        
        float p = params[pi] / decoder_divider;
        uint16_t paramPayload = LMIC_f2sflt16(p);
        byte p_low = lowByte(paramPayload);
        byte p_high = highByte(paramPayload);
        
        payload[pj]=p_low;
        payload[pj+1]=p_high;
        }

        Serial.print("Size of payload = ");
        Serial.println(sizeof(payload));
        
        //LMIC_setTxData2(1, message.getBytes(), sizeof(message.getBytes()), 0);
        LMIC_setTxData2(1, payload,sizeof(payload), 1);
    }
    // Next TX is scheduled after TX_COMPLETE event.
}

void setup() {

   mySDI12.begin();
  pinMode(LED_BUILTIN, OUTPUT);
  pinMode(DONE_PIN, OUTPUT);
  digitalWrite(DONE_PIN, LOW);
  
  
    delay(5000);
    //while (! Serial)
    //    ;
    Serial.begin(9600);
    Serial.println(F("Starting"));

    //dht.begin();
    
    #ifdef VCC_ENABLE
    // For Pinoccio Scout boards
    pinMode(VCC_ENABLE, OUTPUT);
    digitalWrite(VCC_ENABLE, HIGH);
    delay(1000);
    #endif

    // LMIC init
    os_init();
    // Reset the MAC state. Session and pending data transfers will be discarded.
    LMIC_reset();

    LMIC_setLinkCheckMode(0);
    LMIC_setDrTxpow(DR_SF7,17);
    LMIC_selectSubBand(1);


  
        Serial.println(F("Packet queued"));
        
        
    // Start job (sending automatically starts OTAA too)
    do_send(&sendjob);
}

void loop() {
    os_runloop_once();
}
