edgecollective/soil-health/(commit log)

2020-03-01 final touches
    [knuth-gateway.kicad_pcb, knuth-gateway.sch]
2020-03-17 fixed layout to re-route pin 6 and added silk screen for pcb production
    [knuth-gateway.kicad_pcb]
2020-03-17 silk screen fixes, minor part movements
    [knuth-gateway.kicad_pcb]
